msx-hws/FC4MSX/images/case_back.jpeg

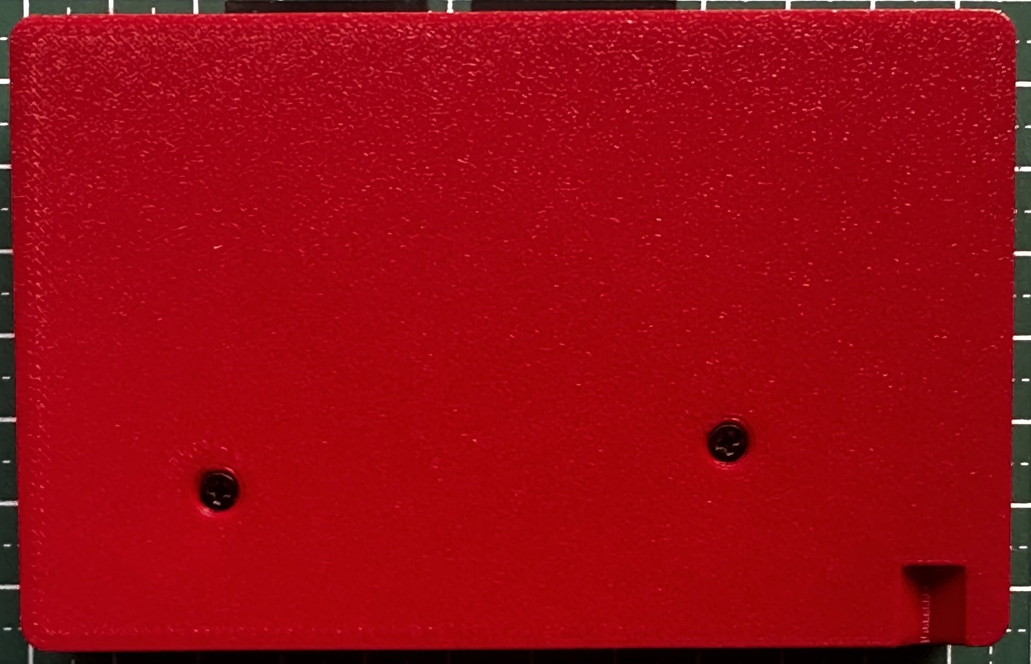
images/case_back.jpeg
