msx-hws/FC4MSX/images/case_front.jpeg

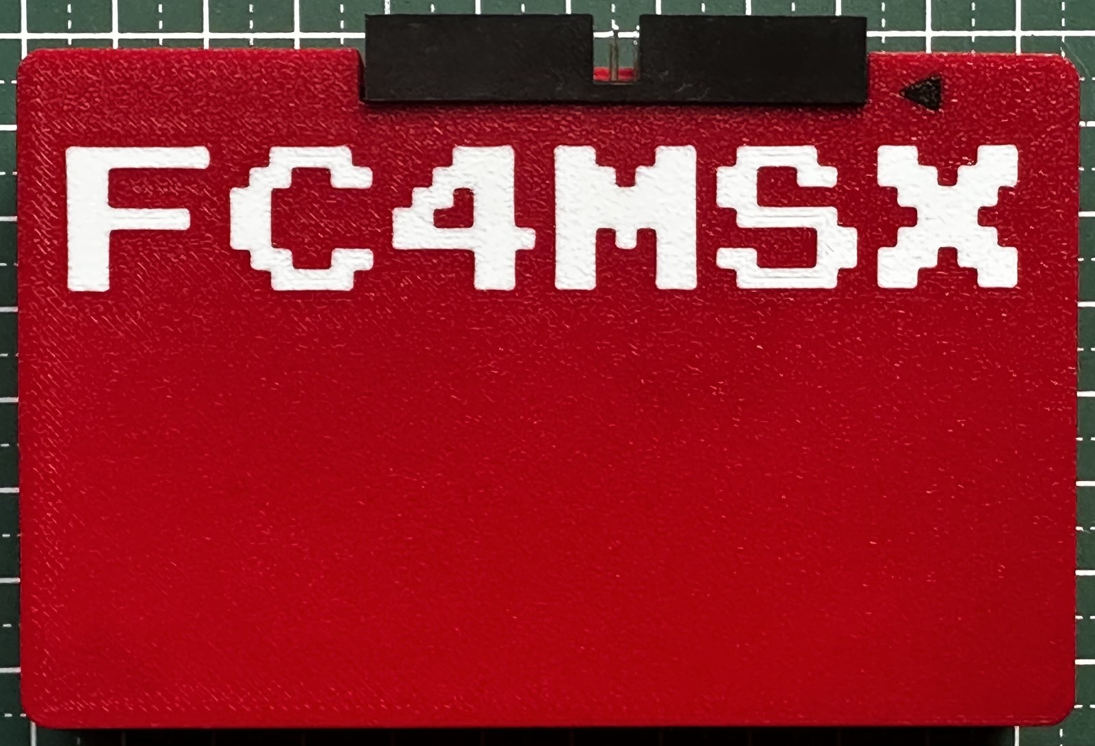
images/case_front.jpeg
