msx-hws/FC4MSX/images/case_top.jpeg

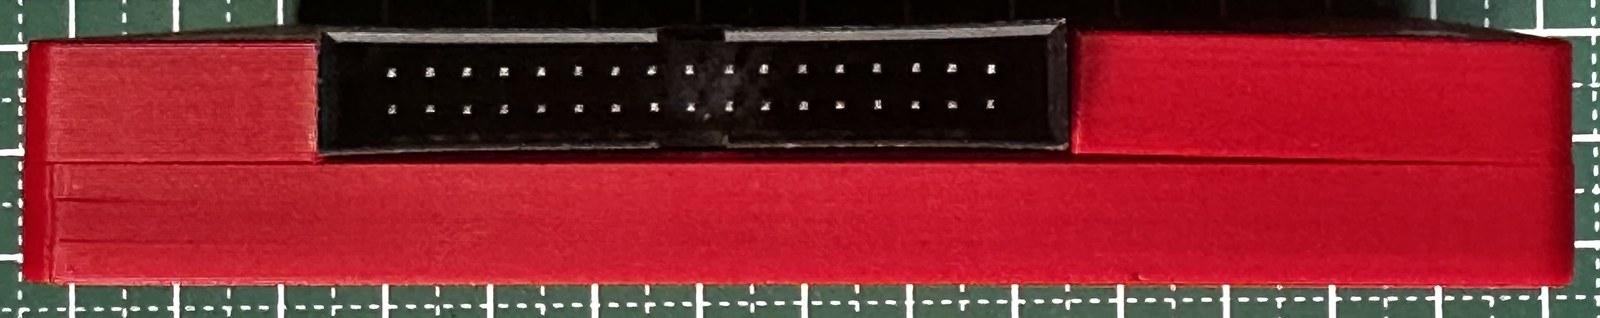
images/case_top.jpeg
