msx-hws/FC4MSX/images/pcb_back.jpeg

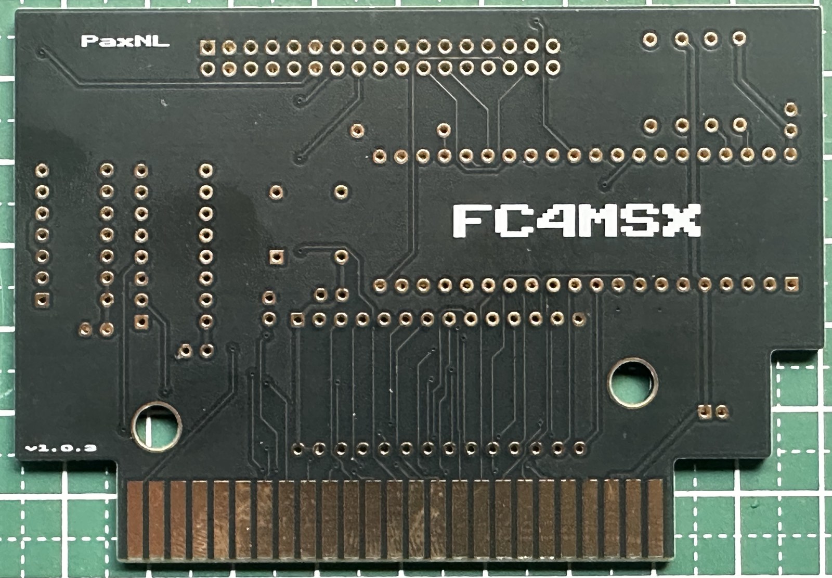
images/pcb_back.jpeg
