msx-hws/FC4MSX/images/pcb_front.jpeg

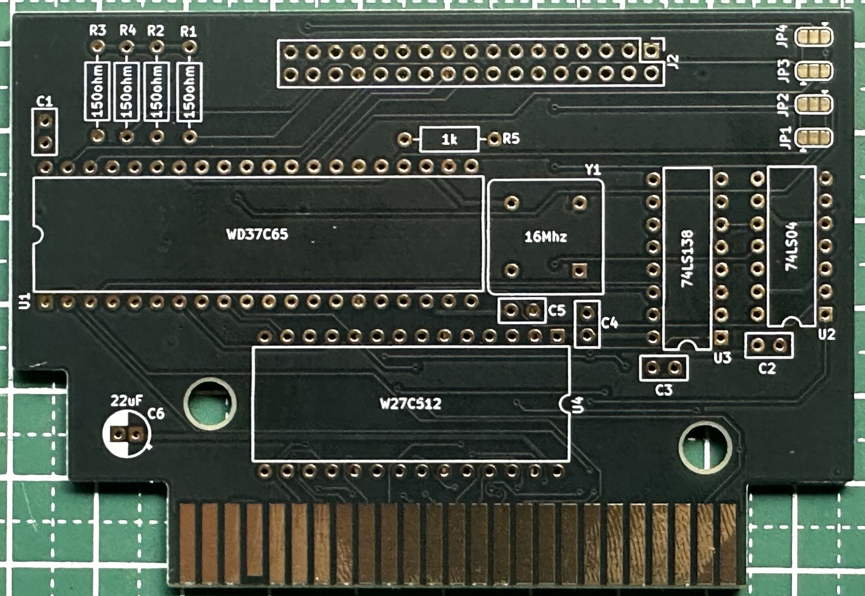
images/pcb_front.jpeg
