msx-hws/FC4MSX/3d-enclosure/FC4MSX.3mf

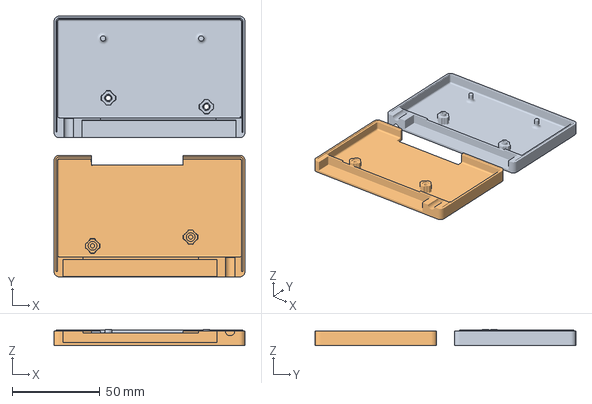
[picture p14: CAD file, 2026-10-10]
3d-enclosure/FC4MSX.3mf
109.0 x 148.8 x 9.40 mm
bottom
top
