msx-hws/FC4MSX/3d-enclosure/FC4MSX-bottom.stl

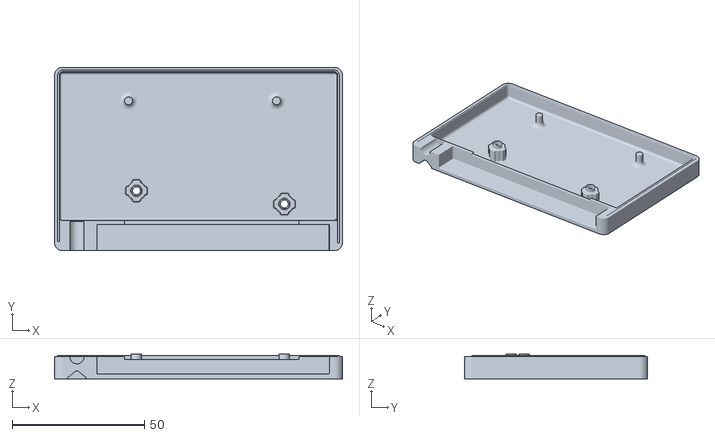
[picture p15: CAD file, 2026-10-10]
3d-enclosure/FC4MSX-bottom.stl
109.0 x 69.4 x 9.40
