msx-hws/FC4MSX/3d-enclosure/FC4MSX-top.stl

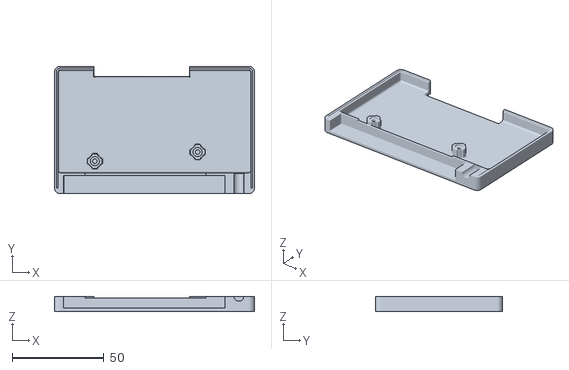
[picture p16: CAD file, 2026-10-10]
3d-enclosure/FC4MSX-top.stl
109.0 x 69.4 x 8.40
