msx-hws/FC4MSX/(commit log)

2026-10-10 Add Gerbers v1.0.3, Interactive BOM (ibom), 3D enclosure STL/3MF models, and component documentation
    [FC4MSX-B_Cu.gbr, FC4MSX-B_Mask.gbr, FC4MSX-B_Paste.gbr, FC4MSX-B_Silkscreen.gbr, FC4MSX-Edge_Cuts.gbr, FC4MSX-F_Cu.gbr, FC4MSX-F_Mask.gbr, FC4MSX-F_Paste.gbr]
2026-10-10 Add high-resolution KiCad 3D renders of PCB (top, bottom, isometric) to images/ and README
2026-10-10 add TDC600EN.ROM and staged smoke test procedure
2026-10-10 add product photos of assembled case and bare PCB v1.0.3
2026-10-10 move case photos to 3d-enclosure, PCB photos to gerbers, and restore 3D renders in main README
2026-10-10 add live interactive BOM GitHub Pages link and set linguist documentation on HTML
2026-10-11 add quantity count to BOM table in README
